MatthiasVermot-Desroches/Projet-ROB3/README.md

# Projet-ROB3: Polydar
robot Cartographe autonome à 6 roues    
  
Six-wheeled autonomous mapping robot
