MatthiasVermot-Desroches/Projet-ROB3/ROS/README.md

Ce dossier contient tous les scripts utilisés pour la partie ROS du projet.
Cela inclut la création d'une carte à partir d'un LiDAR et un début d'autonomisation des déplacements du robot
