MatthiasVermot-Desroches/Projet-ROB3/Code arduino/detection ultrasons/README.md

Ce dossier contient tout le programme axé sur la rotation du robot en cas de détection d'obstacles à l'aide de capteur ultrason.
Le programme servirai dans les cas où le LIDAR tombe en panne ou en cas d'objets non détectés par le LIDAR (notamment les objets en verres comme des fenêtres, vitres etc.)

Le dossier rotation_servomoteurs contient le code devant assurer la rotation du robot à l'aide de servomoteurs. La version actuelle est fonctionnelle mais uniquement avec un seul servomoteur de branché.
Ce fichier est à l'abandon pour l'instant car, suite à un changement de châssis, nous n'utilisons pour l'instant plus de servomoteurs.

Le dossier rotation_moteurs contient le code devant assurer la rotation du robot à l'aide de moteurs, donc de variations den vitesses.
La version actuelle n'a pas été testée en pratique (elle a été testé avec 2 moteurs branchés mais non fixés sur le châssis).
