MatthiasVermot-Desroches/Projet-ROB3/Vermot-Desroches Matthias/Boitier arduino/Readme.md

Réoertoire contenant les fichiers du projet boitier arduino
