MatthiasVermot-Desroches/Projet-ROB3/Rapports seances/rapportsMatthiasVD/rapportseance20.docx

Vermot-Desroches Matthias

Rapport de séance n°20

During this session, I finally managed to install ROS on the NVIDIA card and started learning how to use it. I also re made the Arduino card’s box.

First, with Nino, we changed the place of the home directory in the NVIDIA card. This was done to have enough space for the ROS installation on the card instead of the hard disk’s card since we feared a lack of space. Then, we started the ROS installation using the snap command. However, the installation tutorial with this command was not full and even after following it, we still did not have ROS installed. So, we used the apt command in order to install ROS even though we could lack some space. In the end, we had enough space inside the hard disk. And, we now have a lot of space (50 Giga) thanks to the moving of the home directory inside the card.

After that, we spent the remaining time doing ROS tutorials on the official site. For some of them, we needed another screen as they required a graphic interface, and a terminal was not one. So, we took a screen in the Fablab, but for some reason, it did not show anything when plugged to the card. After speaking with Mr. Masson, we could use the rooms projector, and everything went nicely.

Then, I printed the first version of the Arduino’s box. The printing had some issues, so the box was definitely going to be remade, but I used it to check if any changes needed to be done. It turned out that I needed to adjust the fixation point of the card (the extruded cylinder) and the fixation points of the box. Here are some pictures of the first model :

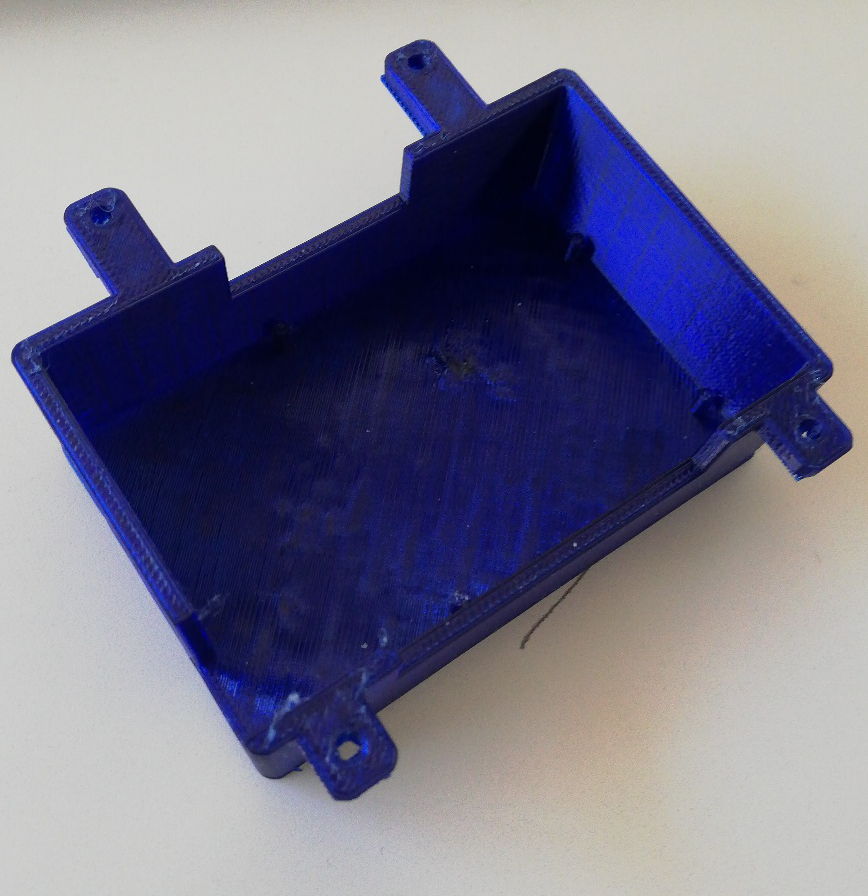
[picture p11: figure]
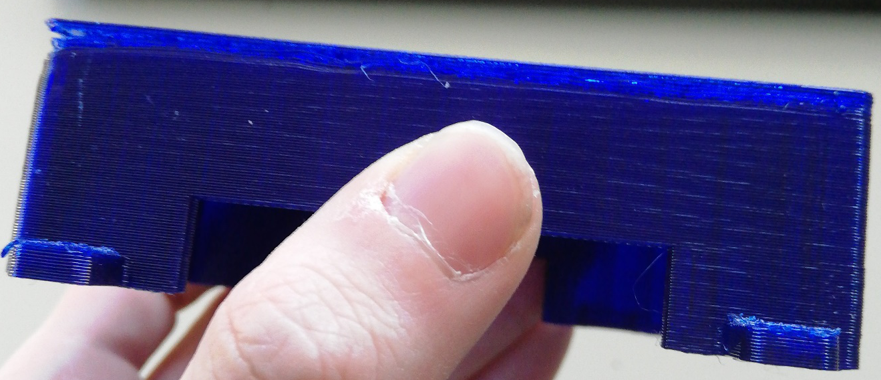
[picture p12: figure]

You can see the printing error that occurred on the picture above.

After that, I modified the CAD model, printed it and checked it. The box is usable, the Arduino card fitted inside, and it can be easily fixated on the frame. Here is a picture of it:

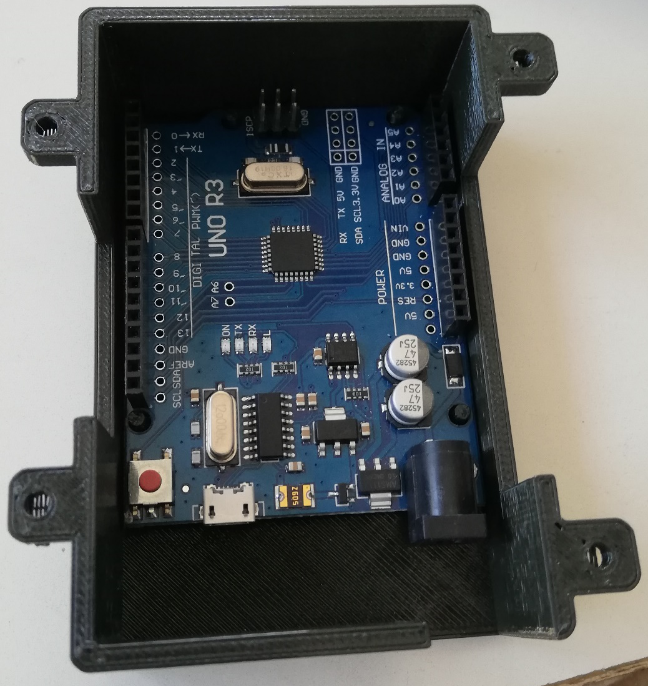
[picture p13: figure]
