MatthiasVermot-Desroches/Projet-ROB3/Rapports seances/rapportsMatthiasVD/rapportseance19.docx

Vermot-Desroches Matthias

Rapport de séance n°19

During this session, I tried again to flash the Nvidia card and started working on an Arduino box that would be fixed on the frame.

I could not finish the download at home during the last session thanks to connections issues. So I tried again with the university network. The download speed was better than my home’s, but some module contained in the download caused some issues. The module was the CUDA one, as for some reasons, the download percentage would randomly decrease instead of increase (going from 30% to 10% for example). This lead to the download being launched at 8 a.m. and not being over at 12 a.m.

At first, I tried to fix the CUDA problem by skipping some steps in the download or just changing the Wi-Fi to my phone’s. But it did nothing.

While waiting for the download to be done, I spoke with Xavier on what I could do in the meantime.

Xavier told me that I could make a better fixation for the Arduino card and maybe improve the motors driver’s one. So, I designed a new box that would be fixed on the same floor as the driver’s one. Here is a picture of the CAD model:

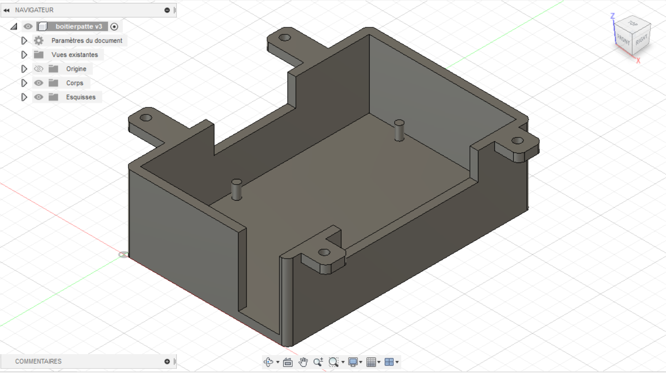
[picture p14: figure]

You can see that there are little parts on the high corners of the CAD. They are here in order to fix the box onto the frame from below, as it would be easier to plug the cables on the Arduino card. The hole in the front is meant to let enough space for the supply plug to fit inside it. The cylinder inside the box are made to maintain the Arduino card in position.

I will try to print the box using a 3D printer during the week.

Next session, I will try another way of downloading ROS on the Nvidia card, verify if the Arduino box is correct and if it is start working on improving the driver’s fixation.
