MatthiasVermot-Desroches/Projet-ROB3/Rapports seances/rapportsMatthiasVD/rapportseance15.docx

Vermot-Desroches Matthias

Rapport de séance n°15

During this session, I finalized placing the motors’ driver and the cable on the frame and started placing the ultrasound sensors.

First, with a huge help from Mr. Masson, we welded the cables in order for them to have a better fixation. Then, I pierced new holes on the frame and screw the lustre terminal on the frame. This made sure that the cables would not be everywhere on the frame. Here is a picture of its position on the frame :

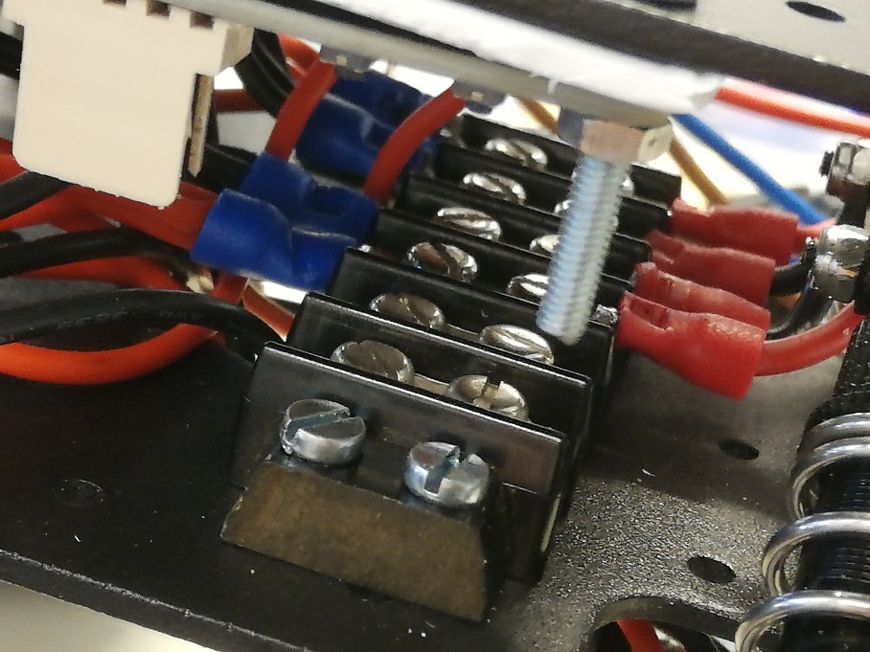
[picture p16: figure]

You can see that I placed the lustre terminal on the bottom floor of the frame and right under the driver’s position, as it will make the cables even less twisted in the frame.

As you saw on the last picture, I also worked on the driver’s fixation. I followed the sketch I did during the last session and remade a plastic support piece. After finding the right screws and nuts, I finally fixated the driver. Here is a picture of it:

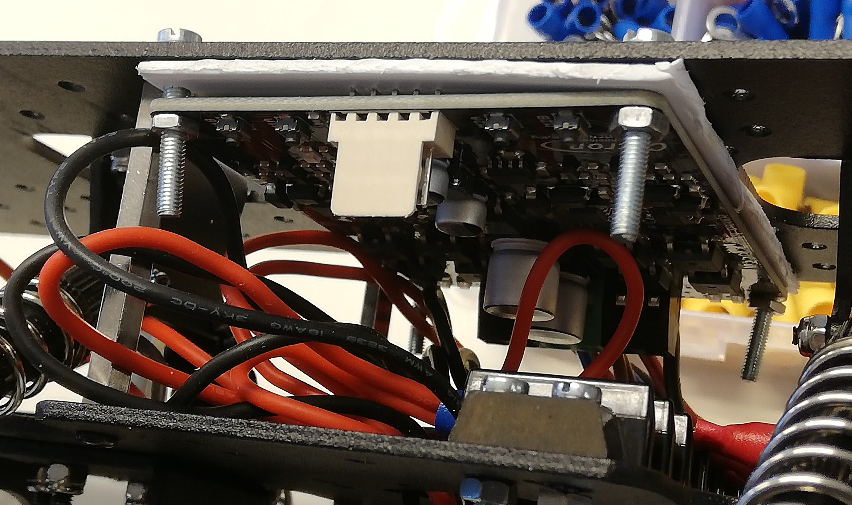
[picture p17: figure]

You can see that not all the bolts are standing straight, it is again due to the plastic being dilated when I pierced it, but this time it should not create any problems. Also, in the end, according to Mr. Masson, the struts were not needed, this is why there are none on the picture.

During the remaining time of this session, I tried to fix the ultrasound sensors on the frame using the adequate support pieces. I decided to place them in a way that make them in the middle of the 2 floors of the frame. So, I pierced new holes on the frame again and placed the support pieces.

Here are pictures of the sensors placed on the frame:

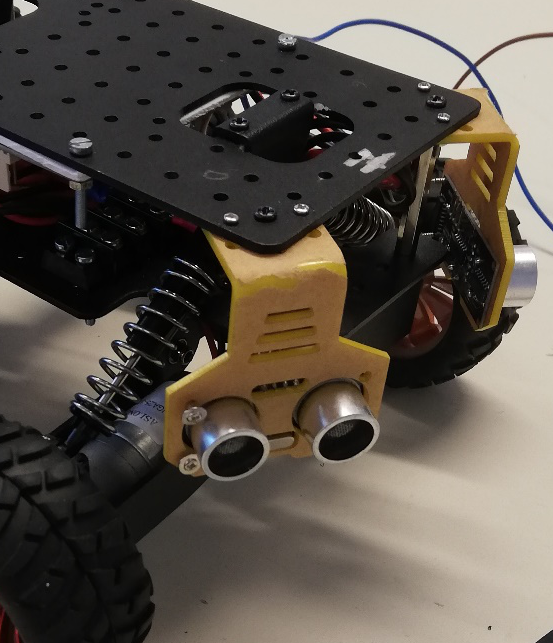
[picture p18: figure]
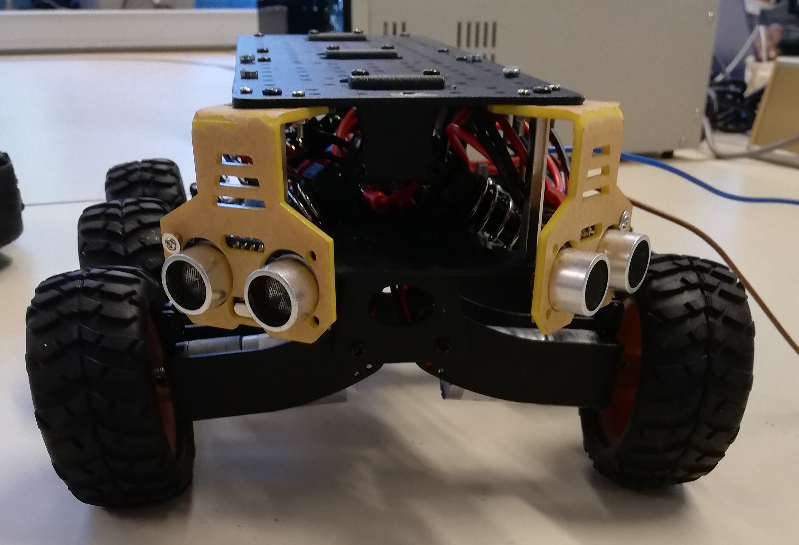
[picture p19: figure]

You can see that, at least for now, the sensors are not on the middle of the frame. But I decided that this position will be what we need.

A problem rose after this, I placed everything on the same side, so I can’t pierce new holes as it could damage the driver. During the next session, I will move the sensors to the other side of the frame and fix a little laser sensor to start making measurements and using the Nvidia card.
