MatthiasVermot-Desroches/Projet-ROB3/Rapports seances/rapportsMatthiasVD/rapportseance4.docx

Vermot-Desroches Matthias

Rapport de séance n°4

During this session, I realized the first wood plate for the wooden model. I tried to make a second one with the same parameter on the cutting machine, but for some reason, the extremities turned into charcoal.

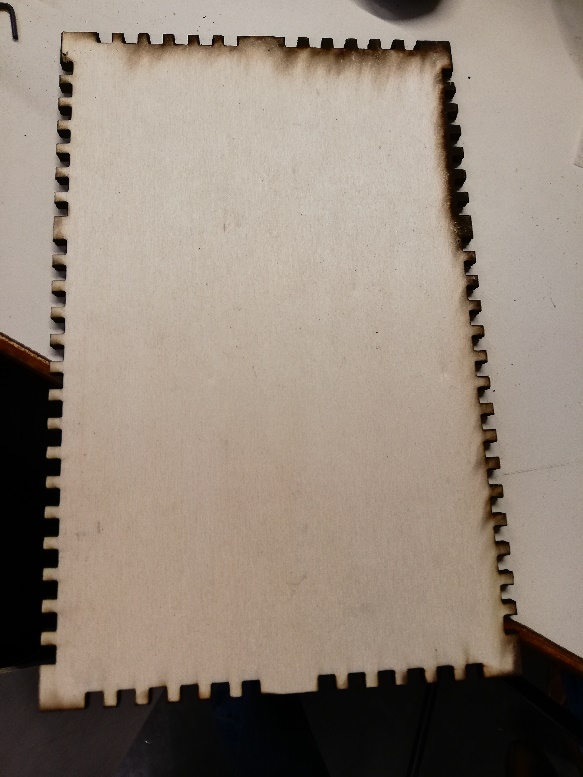
[picture p57: figure]

Here is a picture of the plate I managed to cut.

We also received our motors and wheels, but the diameter of the wheels was smaller than expected and some pieces were different. Mister Masson provided some spare pieces and we chose to use the wheels for now, or at least for the wooden model. Following this decision, I assembled the motors, wheels and other pieces to make the wheel+motor ensemble that we will fix on the servomotor later.
