MatthiasVermot-Desroches/Projet-ROB3/Rapports seances/seance21.pdf

25/04

Le système de fonctionnement du LIDAR a été revue. Les servo-moteurs utilisés pour changer l’inclinaison du miroir ont été remplacés par un moteur pas à pas. Ainsi, le problème de transmission du mouvement des servos moteurs vers le miroir est réglé et la précision est accrue. Le nouveau système fonctionne grace à un plateau positionné sur une vise sans fin qui est fixé au moteur pas à pas via un coupleur. Le plateau consiste de deux plaques qui prennent en étaux la bague qui sert a faire varier la rotation du miroir. Voici la pièce modélisée sur FreeCAD :

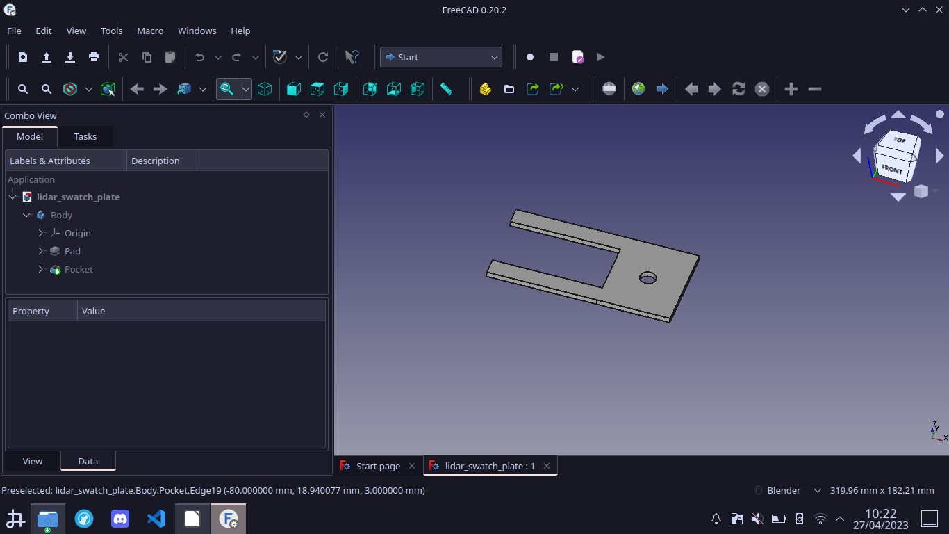
[picture p83: figure]

Le rotor à également été remodélisé pour y ajouter des crans pour que la couroie adhère mieux :

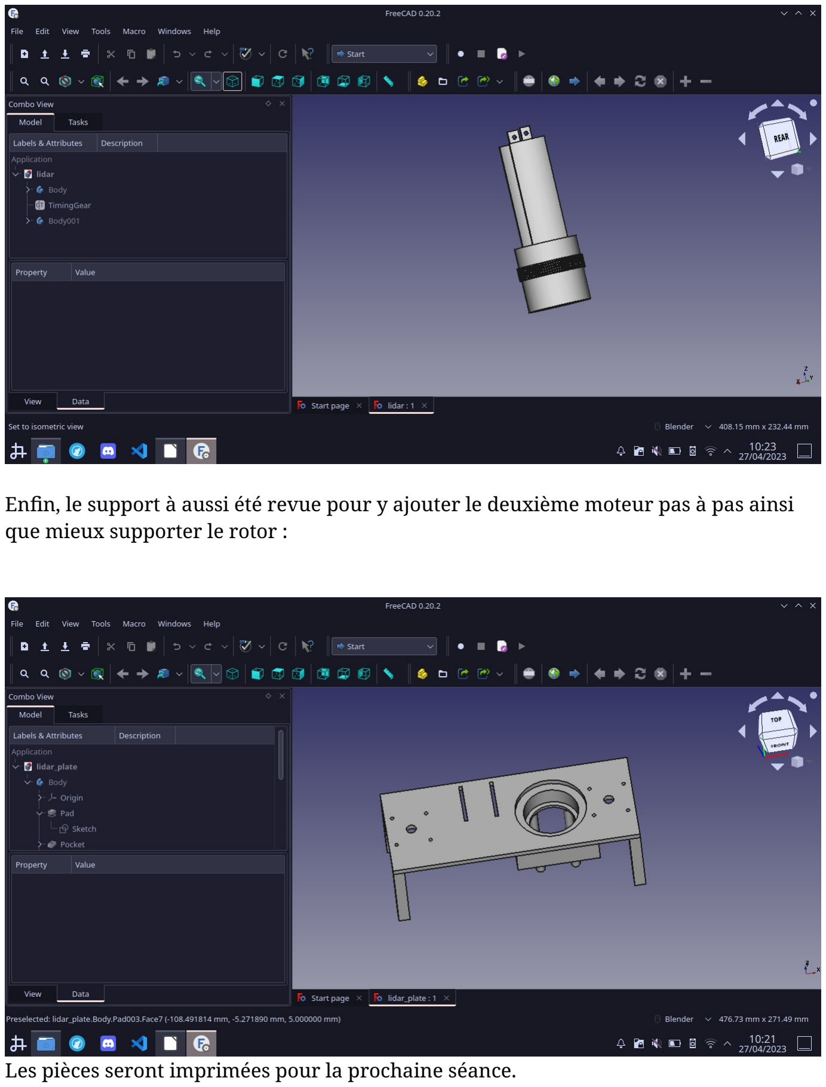
[picture p84: page 2]

Enfin, le support à aussi été revue pour y ajouter le deuxième moteur pas à pas ainsi que mieux supporter le rotor :

Les pièces seront imprimées pour la prochaine séance.
