MatthiasVermot-Desroches/Projet-ROB3/Rapports seances/seance20.pdf

11/04

Installation de ROS avec Mathias et Nino sans oublier de formatter la carte SD et de déplacer le répertoire /home vers la carte SD. On ne peut pas avancer sur la programmation du robot avant d’avoir réussi a faire fonctionner ROS ce qui bloque notre progression. En attendent, j’ai travailler sur l’amélioration du lidar pour le faire fonctionner en 3D. La solution la plus rapide est de refaire les pièces avec la bonne précision et en rallonger les supports car actuellement, il y a trop de frictions ce qui complique la ratation du rotor et bloque le fonctionnement des servos-moteurs (et donc pas de 3D) .
