MatthiasVermot-Desroches/Projet-ROB3/Rapports seances/seance16.pdf

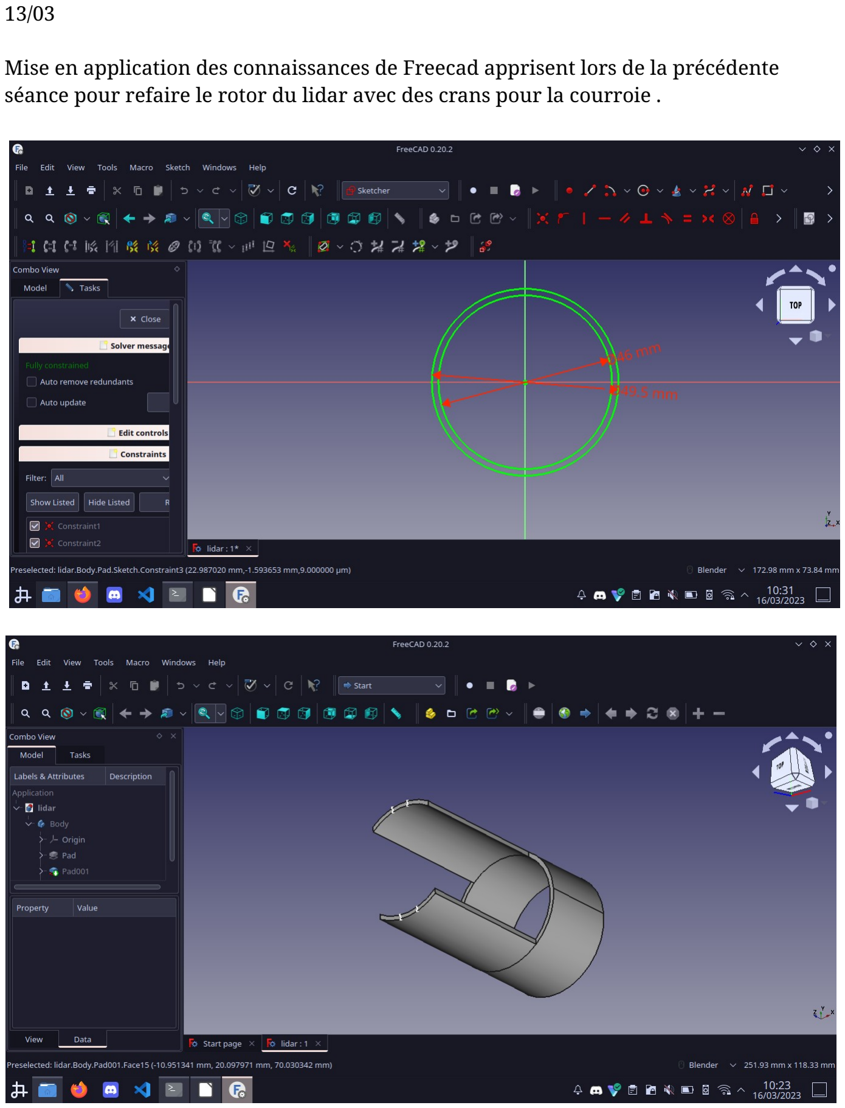
[picture p87: page 1]

13/03

Mise en application des connaissances de Freecad apprisent lors de la précédente séance pour refaire le rotor du lidar avec des crans pour la courroie .

Mise en pause de la fabrication du Lidar pour l’utilisation d’un Lidar industriel RPLIDAR et tentative de le faire fonctionner avec le logiciel fournit “Robostudio”, sans succès.
