MatthiasVermot-Desroches/Projet-ROB3/Rapports seances/seance14.pdf

Séance 14 28/2

Nettoyage des dernières pièces puis assemblages

Le reste de la séance a été passé à essayer de mettre en place les liens entre les servomoteurs et la bague, sans succès… (compliqué à tordre correctement)

IL faut aussi refaire le rotor et ajouter des crans dessus pour que la courroie adhere correctement.

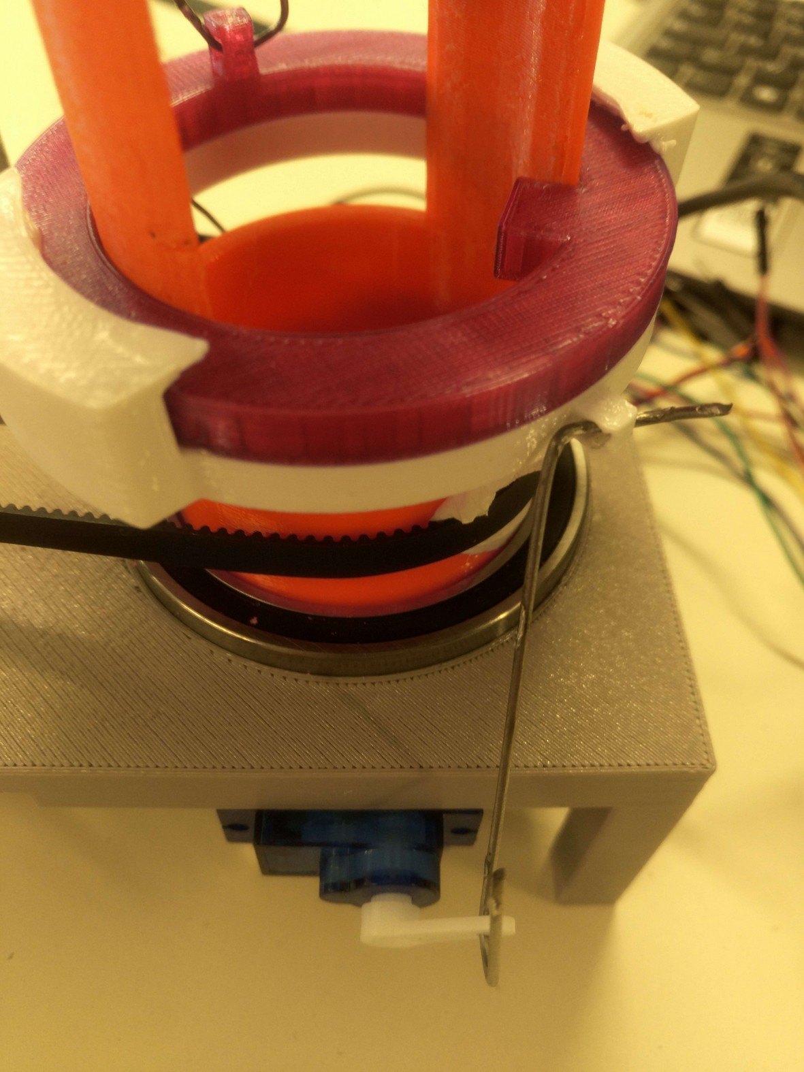
[picture p88: figure]
