MatthiasVermot-Desroches/Projet-ROB3/Rapports seances/seance13.pdf

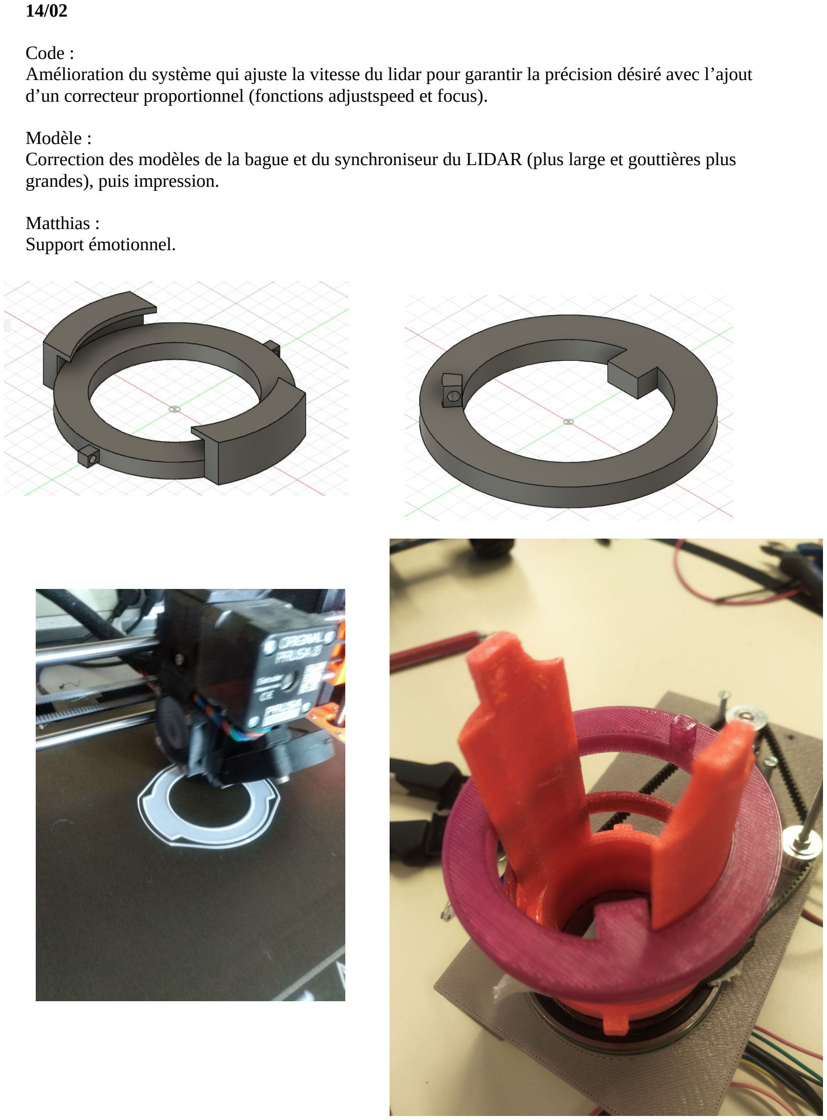
[picture p89: page 1]

14/02

Code :
Amélioration du système qui ajuste la vitesse du lidar pour garantir la précision désiré avec l’ajout d’un correcteur proportionnel (fonctions adjustspeed et focus).

Modèle :
Correction des modèles de la bague et du synchroniseur du LIDAR (plus large et gouttières plus grandes), puis impression.

Matthias :
Support émotionnel.
