MatthiasVermot-Desroches/Projet-ROB3/Rapports seances/seance9.pdf

16/12

Après avoir révisé les pièces, voici le résultat de la nouvelle impression :

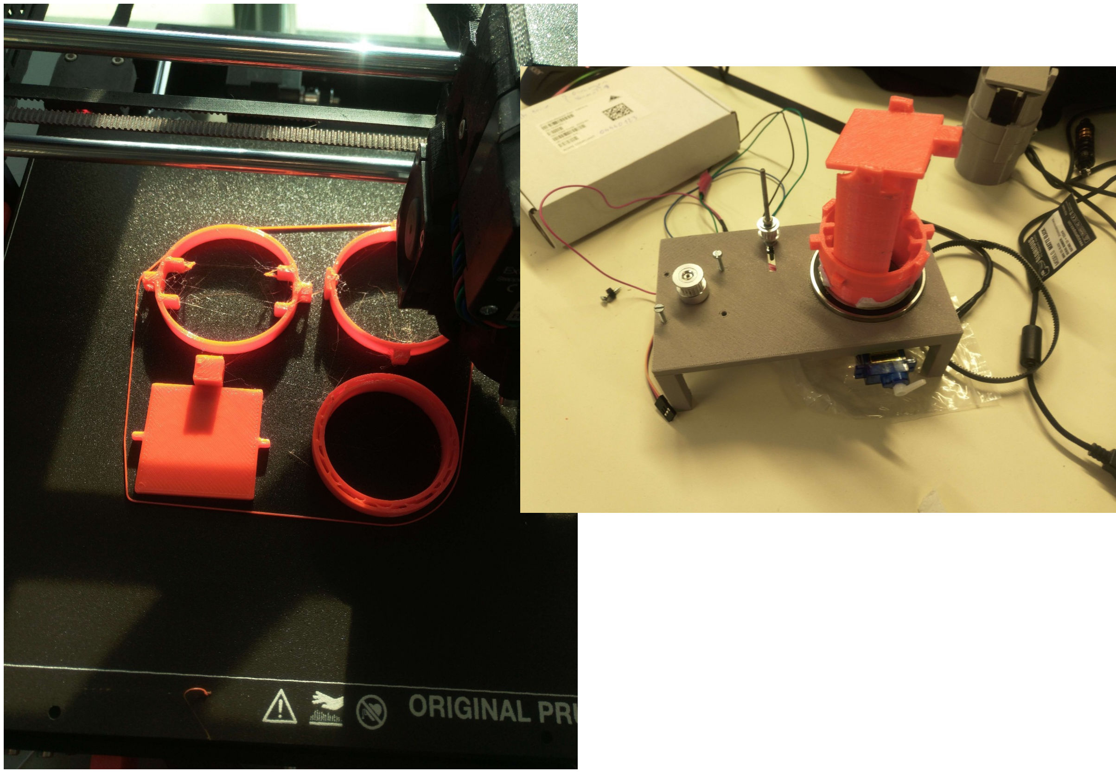
[picture p90: figure]

Il reste encore une erreur sur le synchroniseur mais cette pièce peut être ré-imprimé en quelques minutes.
Il faut cependant trouver une tige assez fine et résistante pour relier le servomoteur à la bague.
