MatthiasVermot-Desroches/Projet-ROB3/Rapports seances/seance7.pdf

09/12

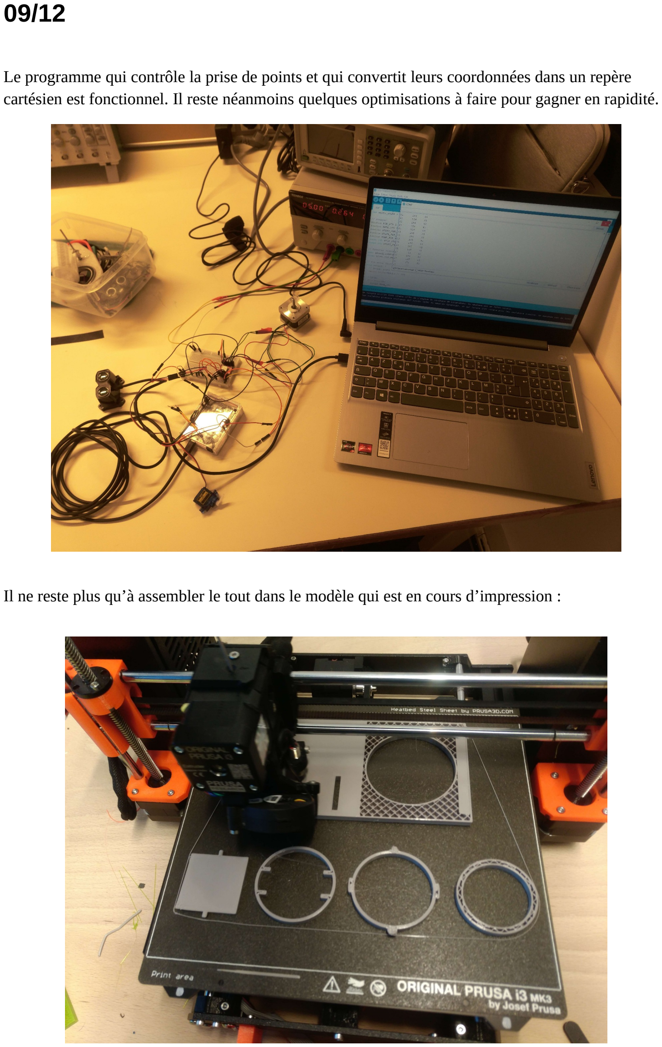
[picture p91: page 1]

Le programme qui contrôle la prise de points et qui convertit leurs coordonnées dans un repère cartésien est fonctionnel. Il reste néanmoins quelques optimisations à faire pour gagner en rapidité.

Il ne reste plus qu’à assembler le tout dans le modèle qui est en cours d’impression :
