MatthiasVermot-Desroches/Projet-ROB3/Rapports seances/seance6.pdf

06/12

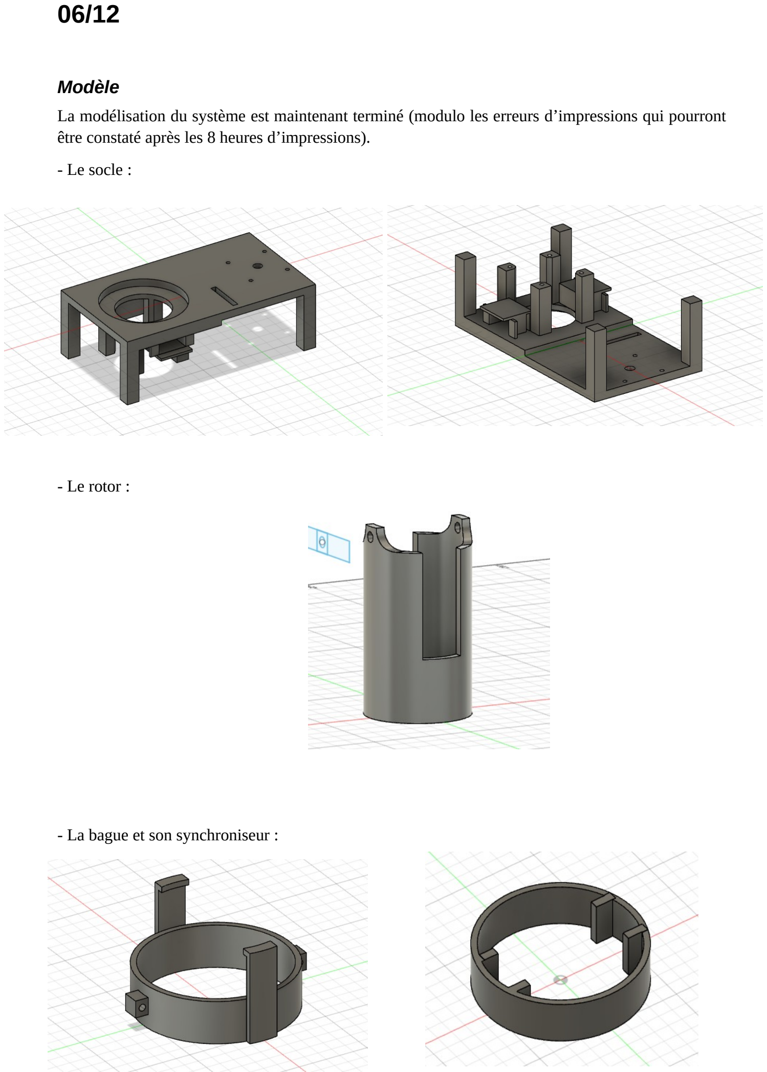
[picture p92: page 1]

Modèle
La modélisation du système est maintenant terminé (modulo les erreurs d’impressions qui pourront être constaté après les 8 heures d’impressions).
- Le socle :
- Le rotor :
- La bague et son synchroniseur :

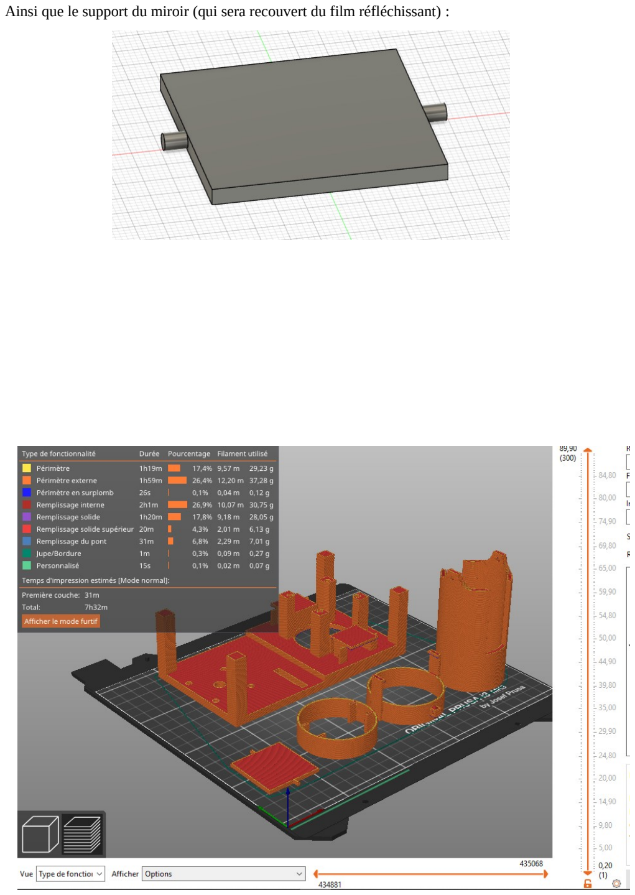
[picture p93: page 2]

Ainsi que le support du miroir (qui sera recouvert du film réfléchissant) :
