MatthiasVermot-Desroches/Projet-ROB3/Rapports seances/seance4.pdf

15/11

Impression
Après nettoyage et un simple ponçage des pièces imprimées à la dernière séance ainsi que l’impression d’une courroie en filament flexible, voici le résultat :

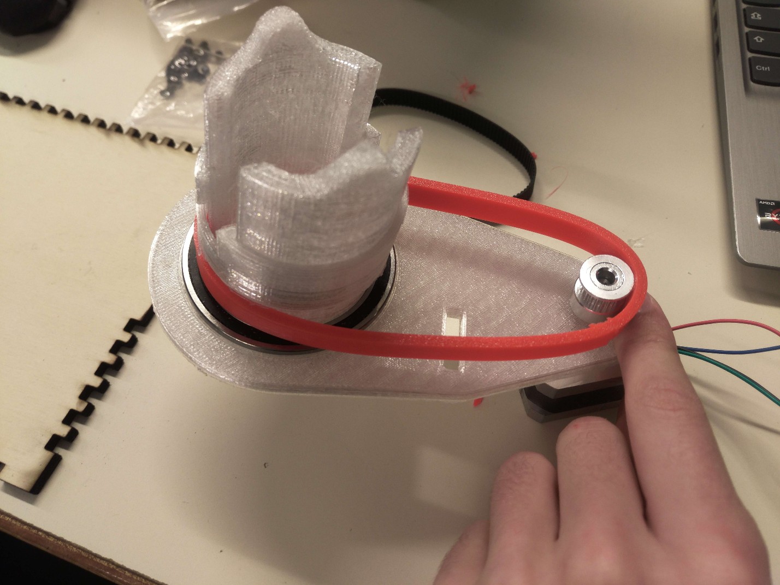
[picture p94: figure]

Plusieurs problème émerge alors :
- Courroie trop large, trop épaisse et trop longue
- Jeu entre le roulement à bille et le rotor
- Syncroniseurs qui translate difficilement
- Plusieurs autres défauts mineurs
Les modèles ont été revu et sont en attente d’impression

LIDAR
Lecture de la datasheet du capteur pour une utilisation rapide (>1000hz).
Début du programme permettant de prendre un nombre de point et de les localiser dans l’espace pour réaliser la cartographie.
