MatthiasVermot-Desroches/Projet-ROB3/Rapports seances/seance3.pdf

28/10

## Modélisation

Finalisation de la modélisation des pièces du LIDAR

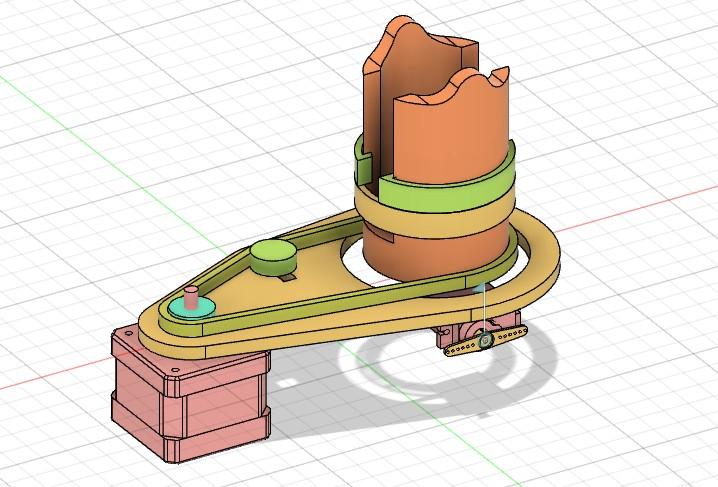
[picture p95: figure]

En orange : la bague
En vert : le synchroniseur En rouge: l’arbre principale En jaune : la courroie
En orange : le socle

## Impression

Début de l’impression 3d des pièces du LIDAR

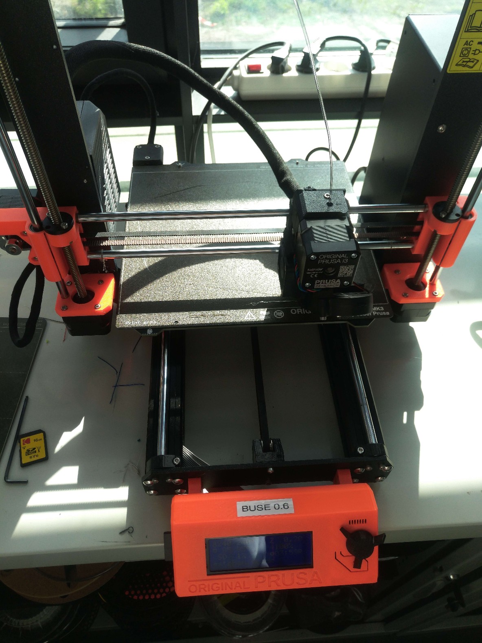
[picture p96: figure]
