MatthiasVermot-Desroches/Projet-ROB3/slide soutenance/soutenance Polydar.pdf

## Le Polydar

Gissinger Esteban et Vermot-Desroches Matthias ROB 3

année 2022-2023

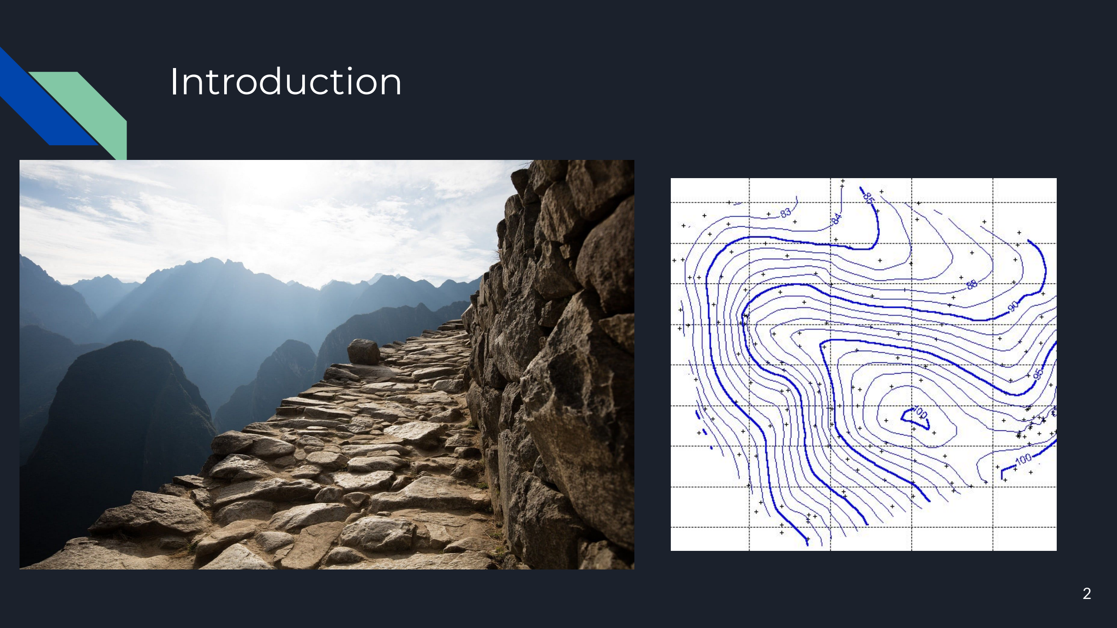
[picture p98: page 2]

Introduction

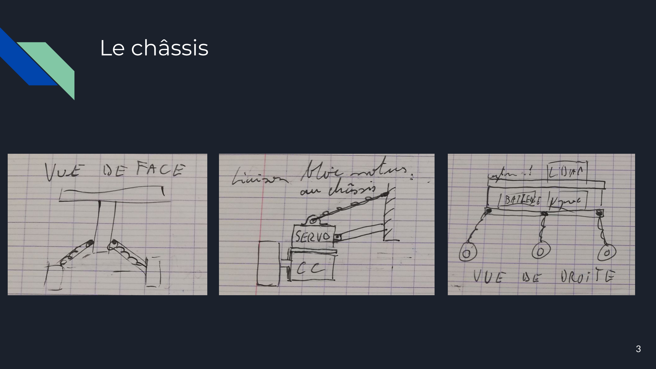
[picture p99: page 3]

Le châssis

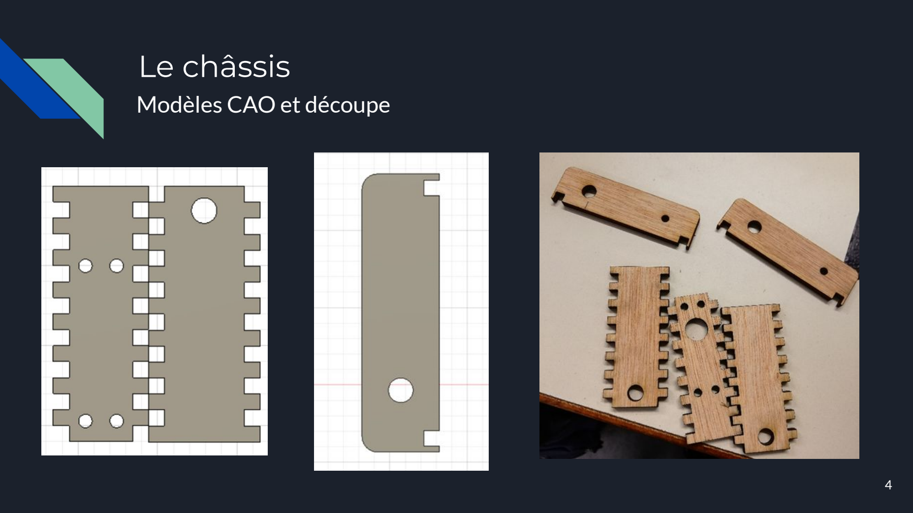
[picture p100: page 4]

Le châssis

Modèles CAO et découpe

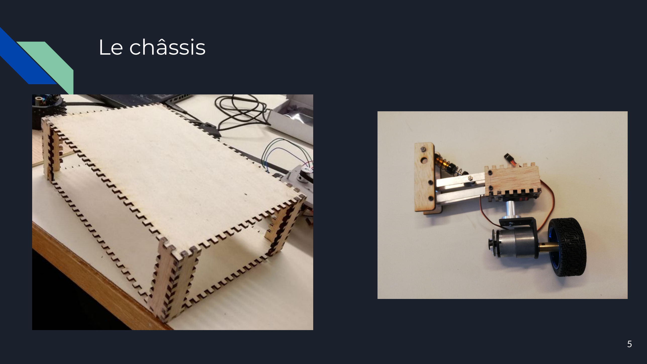
[picture p101: page 5]

Le châssis

Le chassis

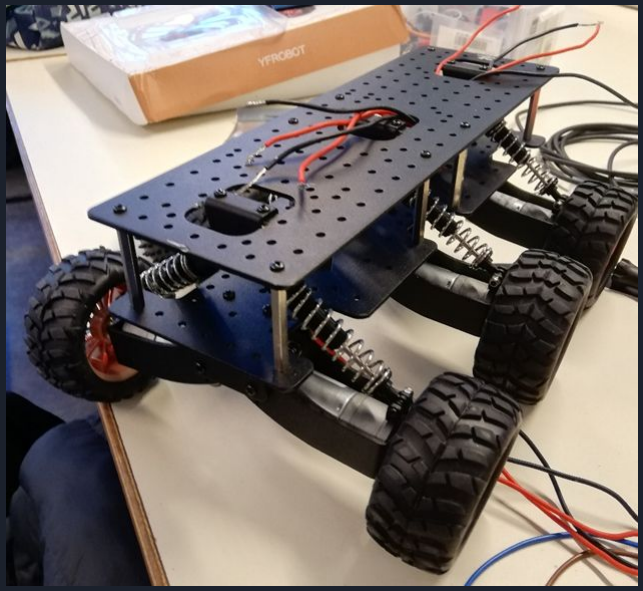
[picture p102: figure]
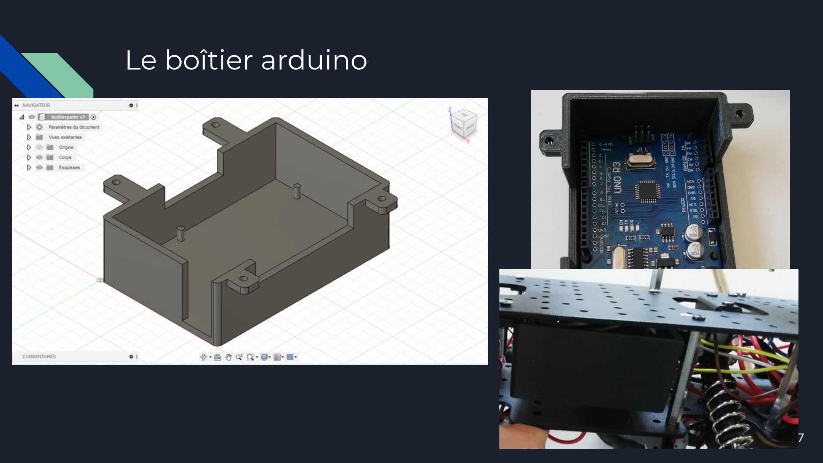
[picture p103: page 7]

Le boîtier arduino

le boîtier arduino

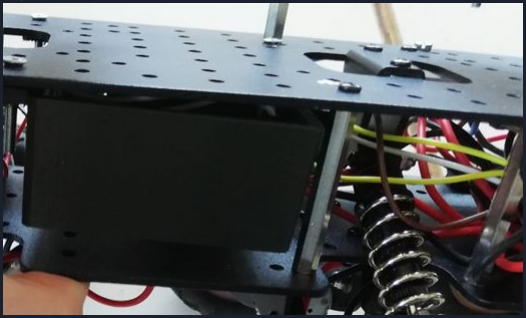
[picture p104: figure]

driver moteur ? capteurs ultrasons? étage pmma ?

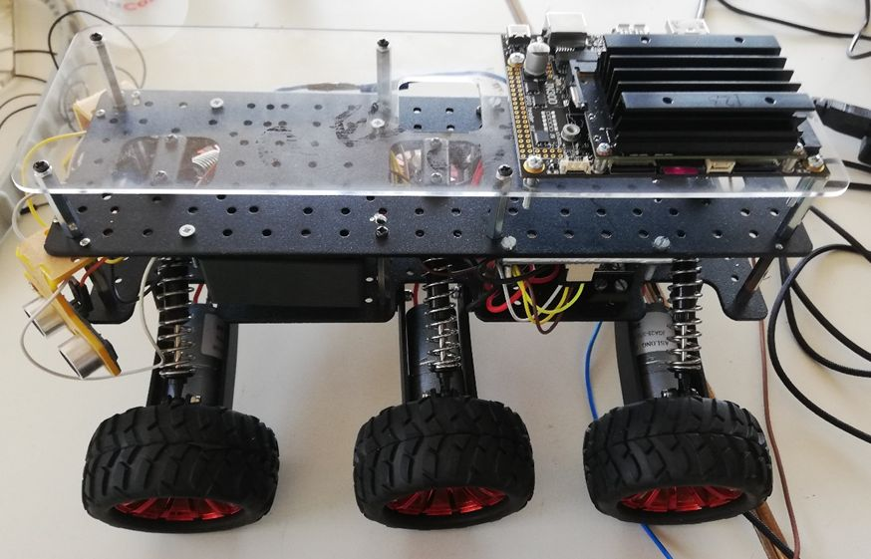
[picture p105: figure]

Le programme Arduino de la commande des moteurs

But : détecter des objets que le Lidar ne peut pas voir. exemple : une vitre, fenêtre

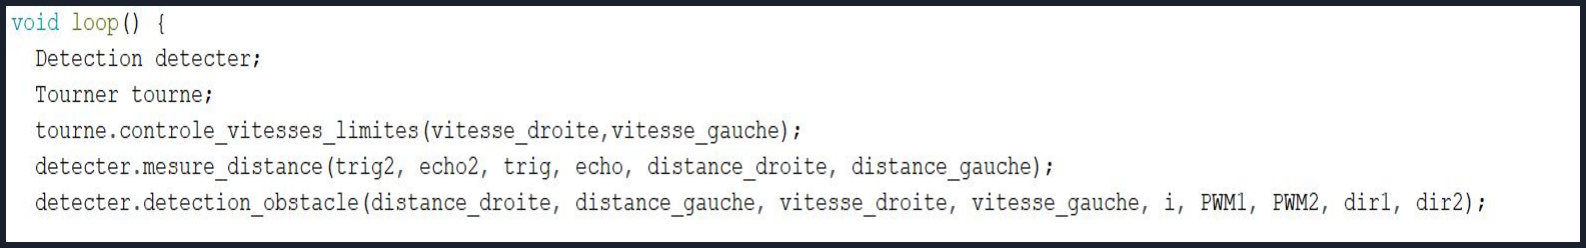
[picture p106: figure]
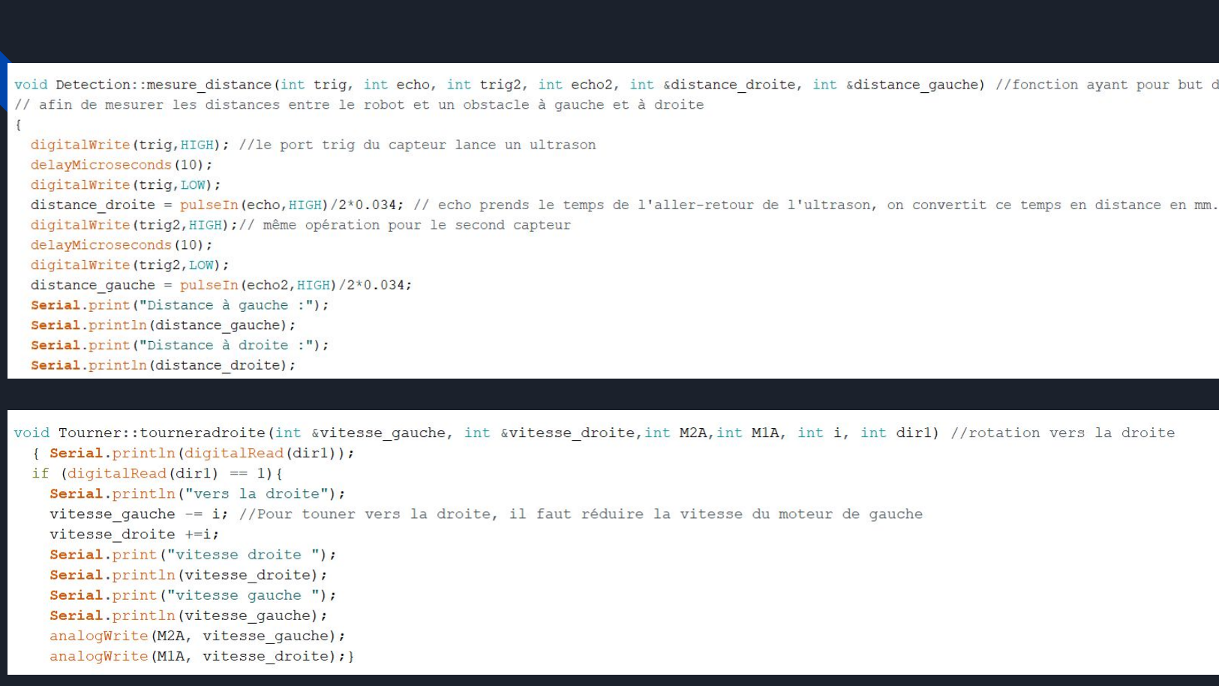
[picture p107: page 11]

Le programme Arduino de la commande des moteurs

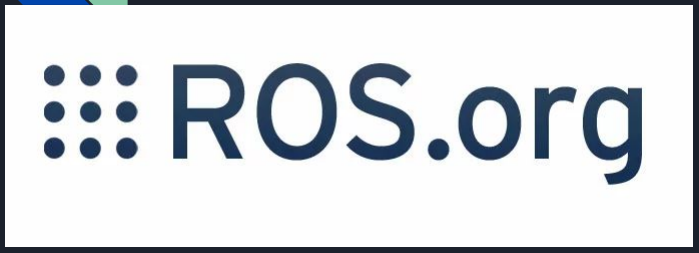
[picture p108: figure]
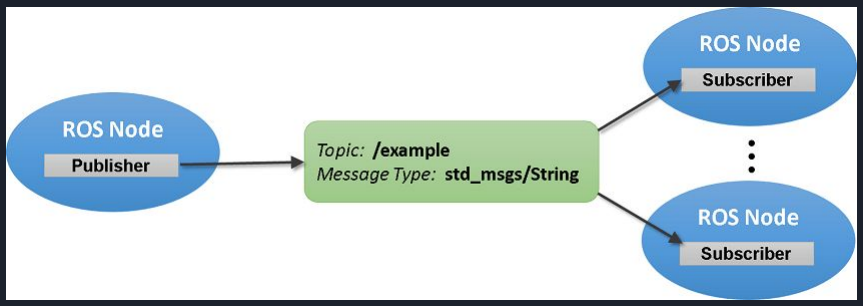
[picture p109: figure]

Permet de diviser les tâches entre Nodes contrôlées par un maître.

-meilleure gestion mémoire et du matériel

Cartographie avec ROS

Robot Operating System

Ensemble de logiciels open source

Cartographie avec ROS

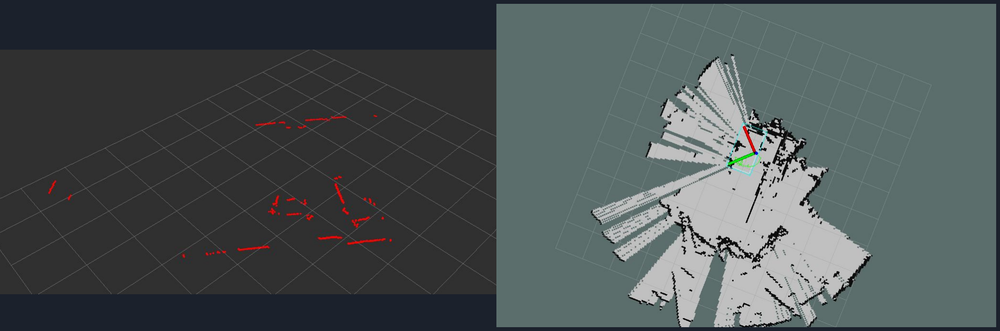
[picture p110: figure]

Sans SLAM | Avec SLAM

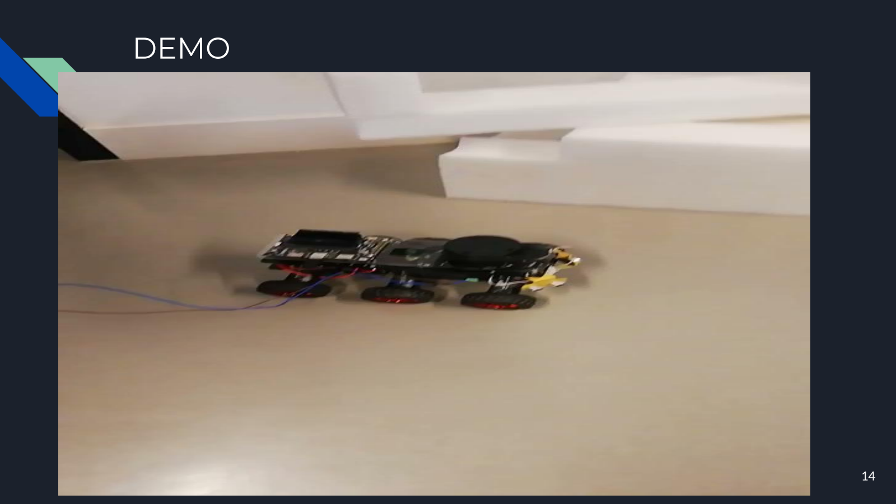
[picture p111: page 14]

DEMO

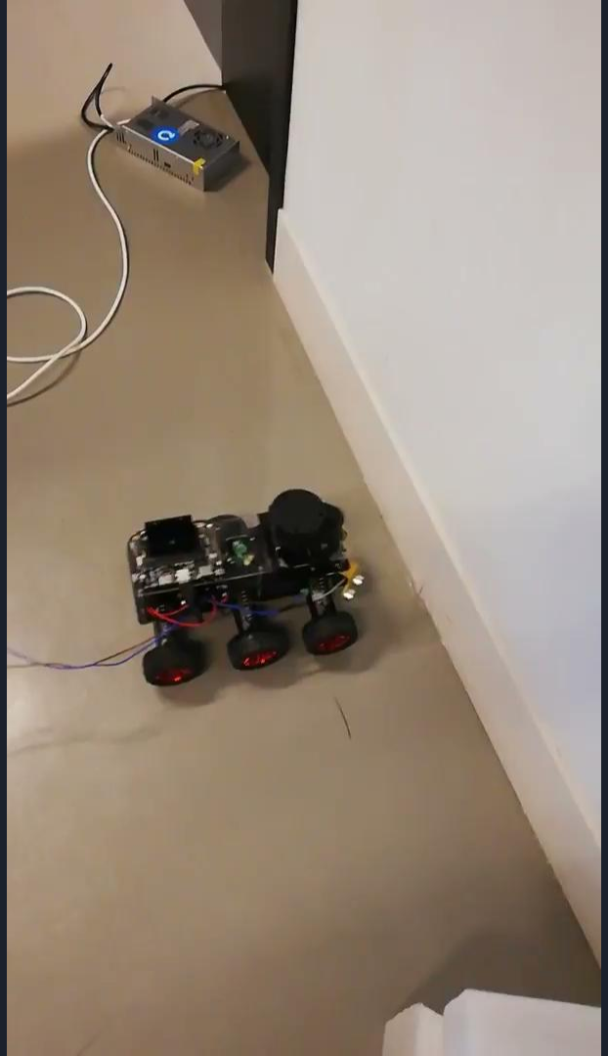
[picture p112: figure]
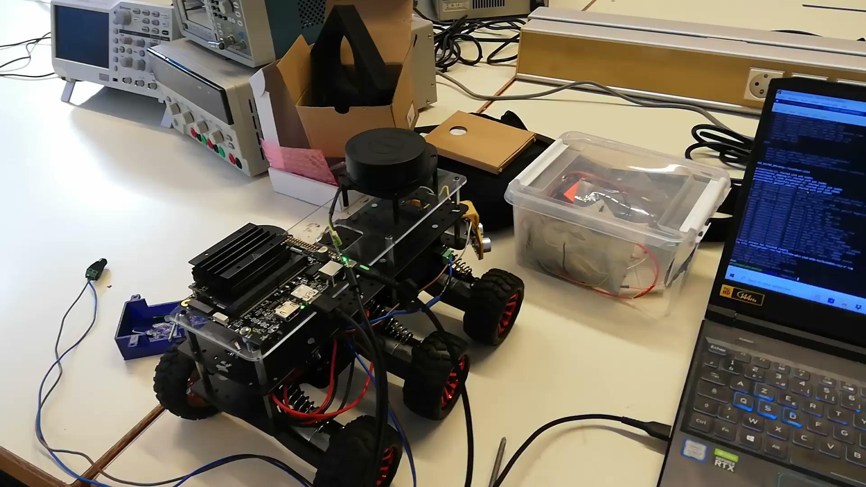
[picture p113: page 16]

PB1 :
lidar 2d

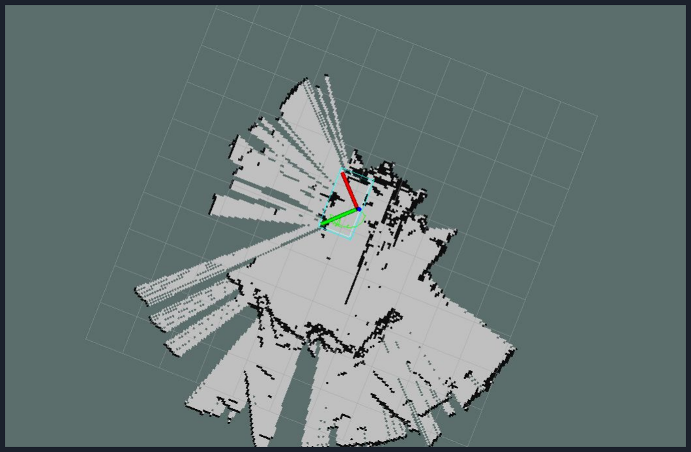
[picture p114: figure]

PB 2 : ROS

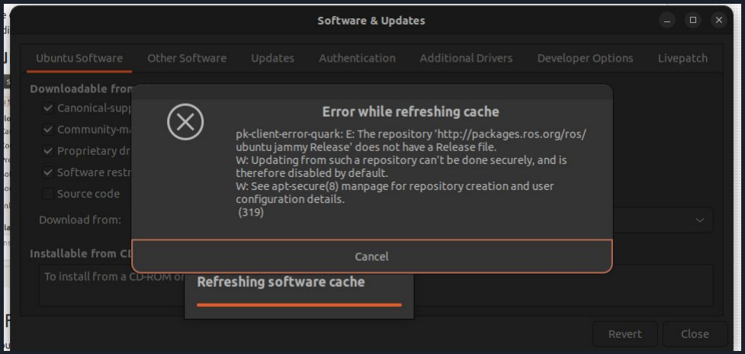
[picture p115: figure]
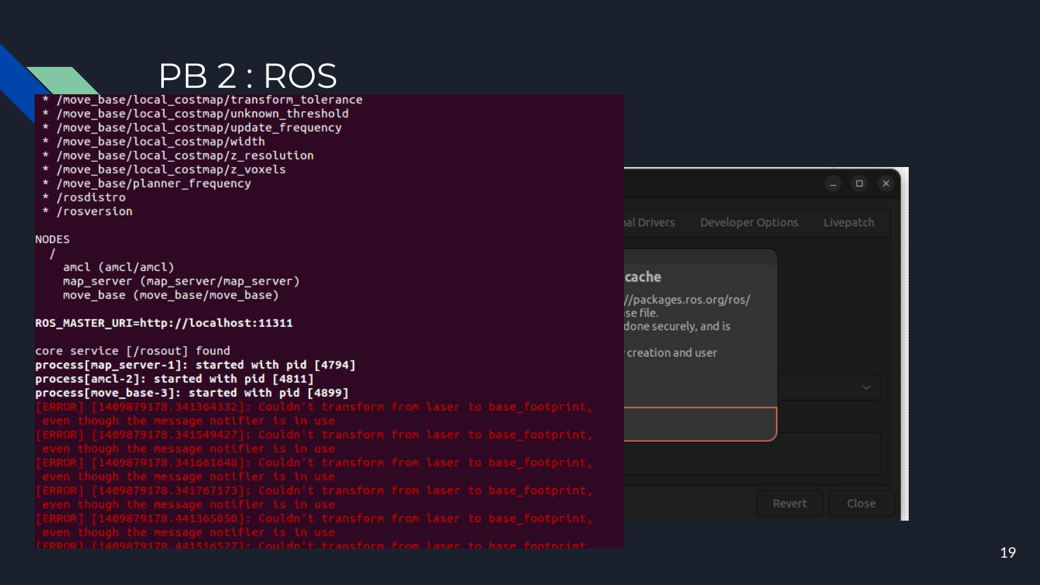
[picture p116: page 19]

PB 2 : ROS

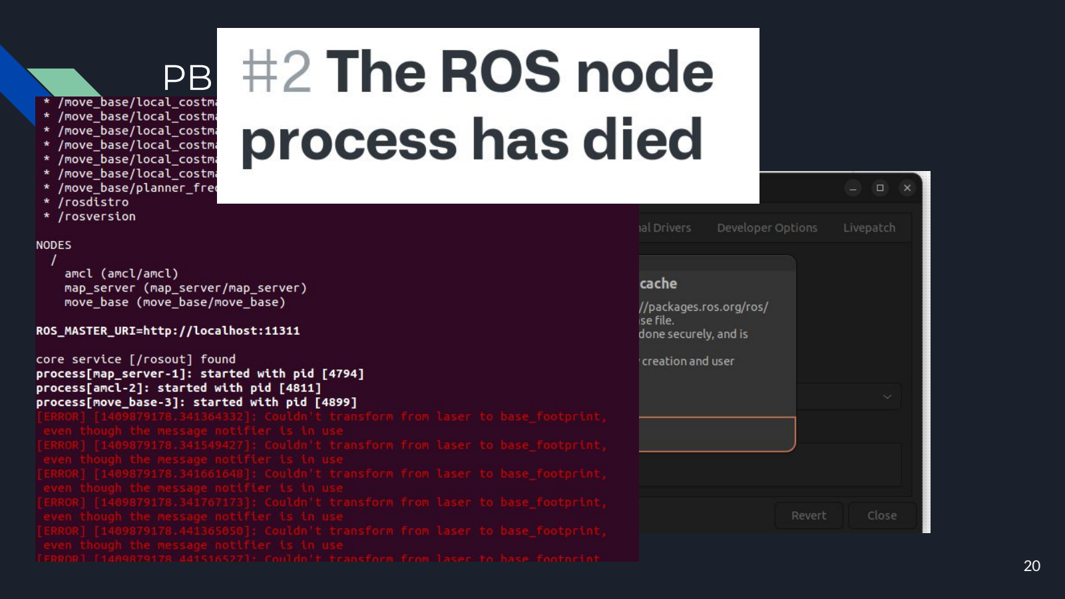
[picture p117: page 20]

PB 2 : ROS

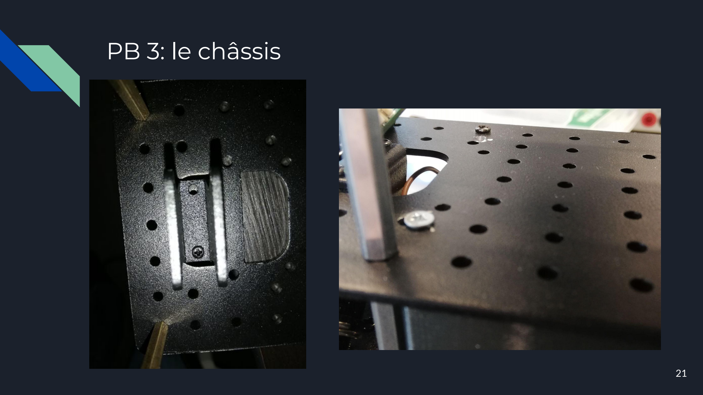
[picture p118: page 21]

PB 3: le châssis

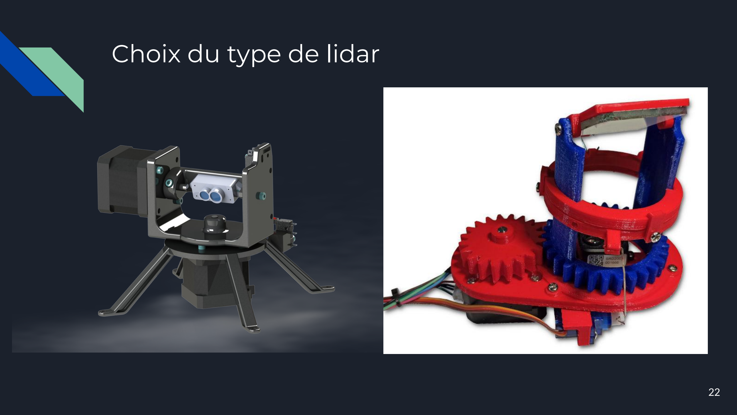
[picture p119: page 22]

Choix du type de lidar

Prototype initial

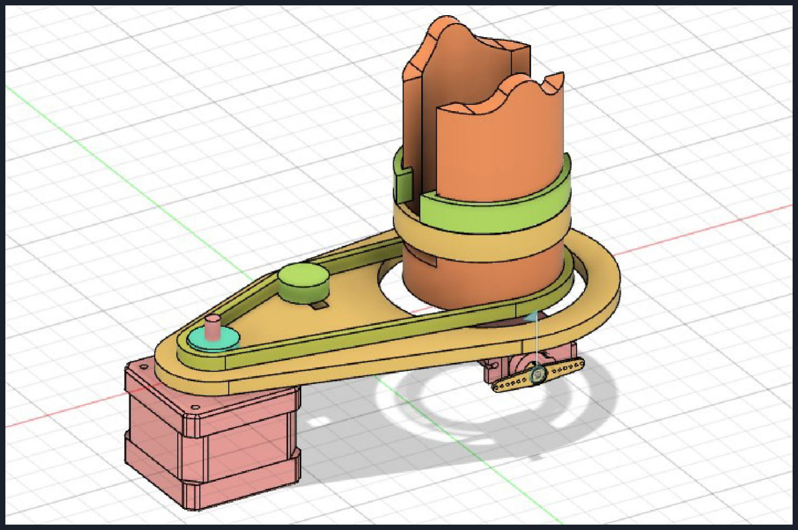
[picture p120: figure]

Mis à jour du design

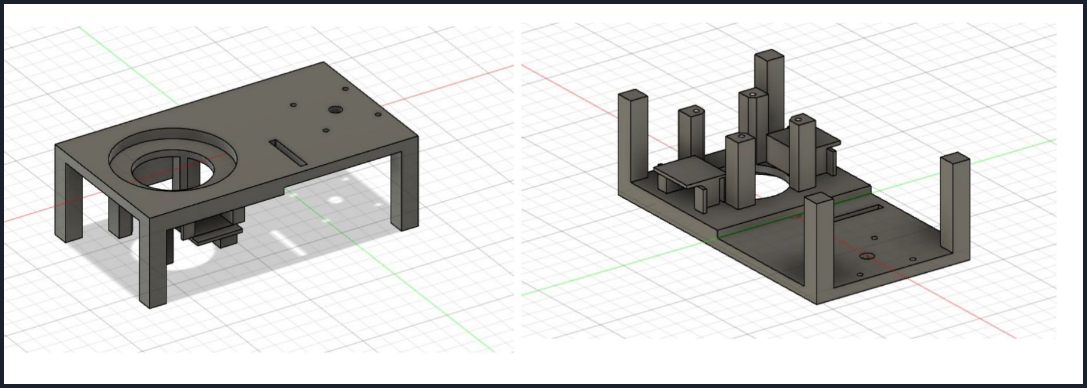
[picture p121: figure]

Mis à jour du design

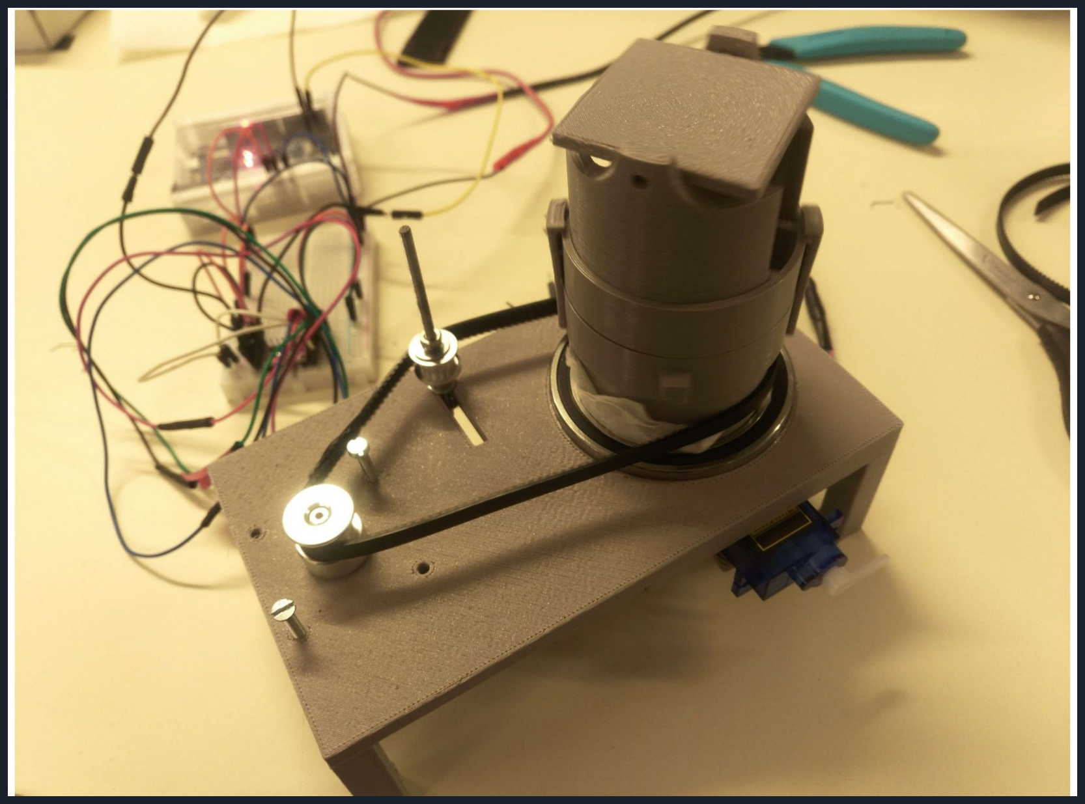
[picture p122: figure]

Correction des erreurs

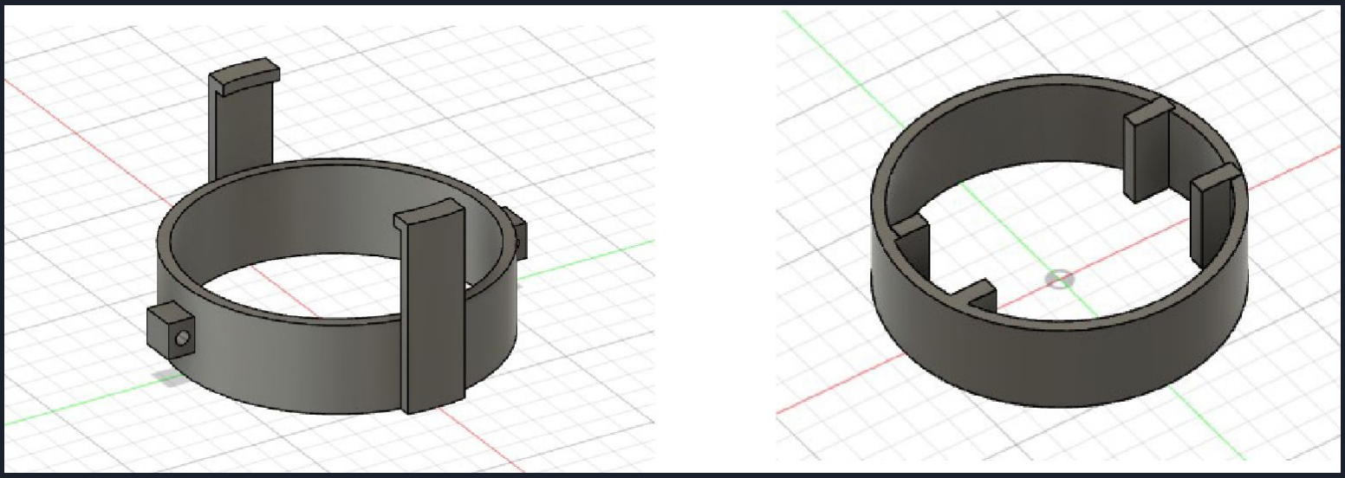
[picture p123: figure]

Nouveaux problèmes

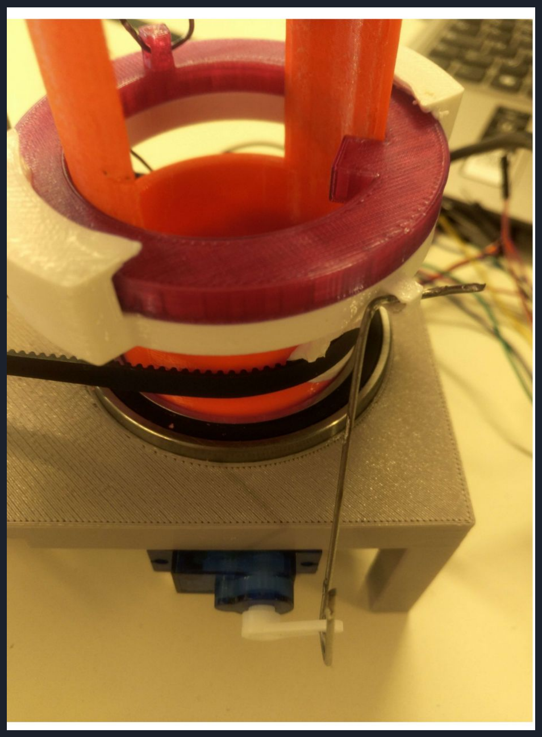
[picture p124: figure]

Visualisation des données

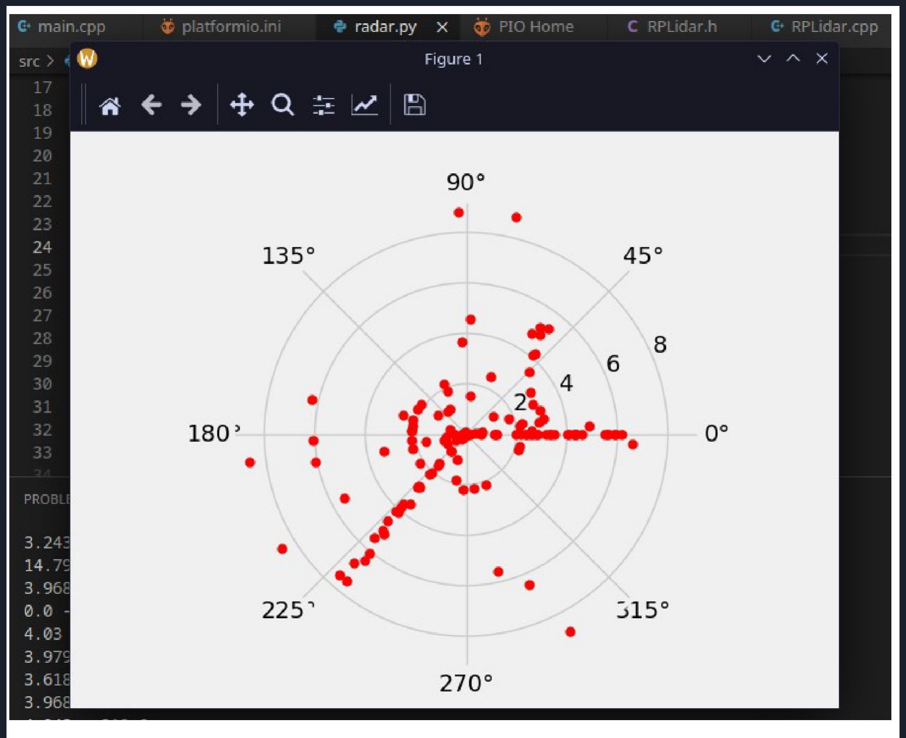
[picture p125: figure]

Cablage LIDAR

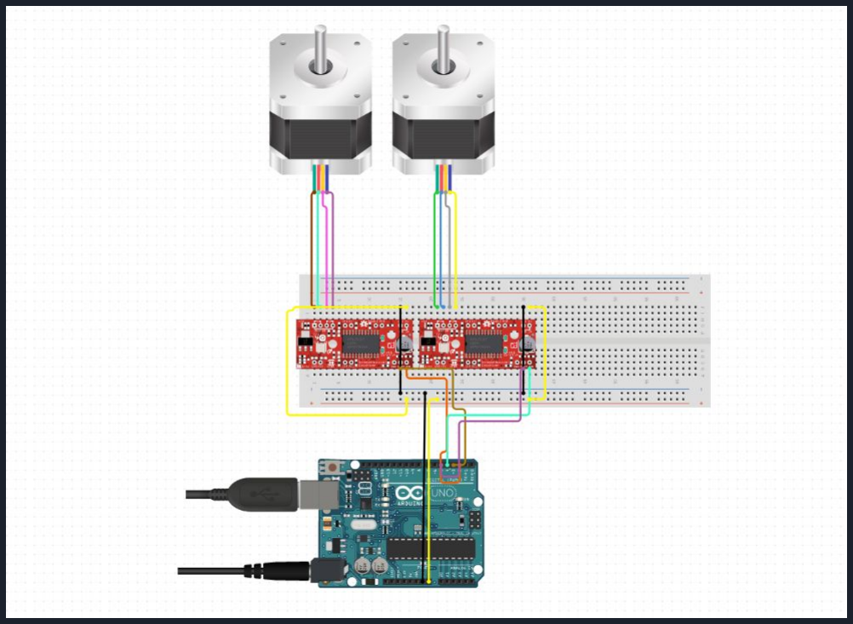
[picture p126: figure]

Programmation LIDAR

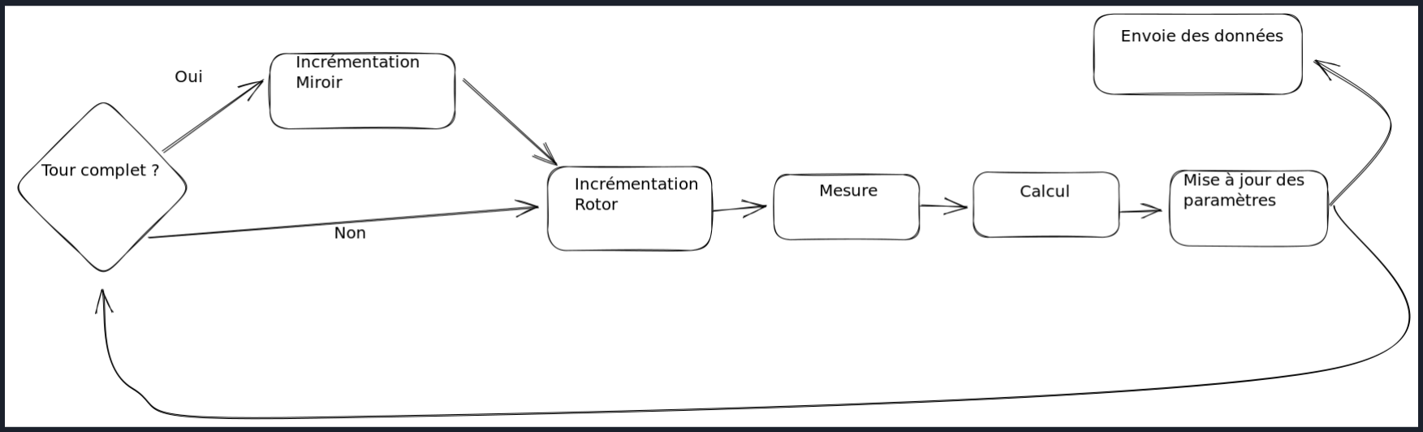
[picture p127: figure]

Conclusion et perspectives d’améliorations

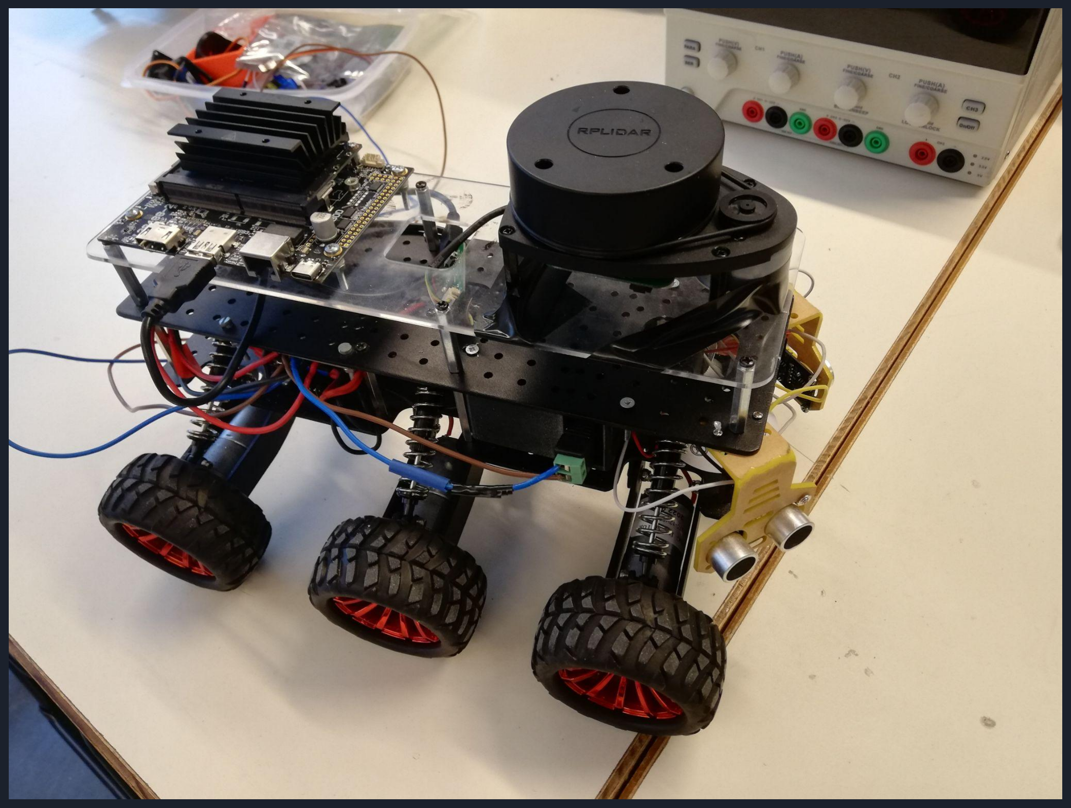
[picture p128: figure]

-navigation avec ROS

-intégration du Lidar sur le châssis

- finir notre propre châssis
- finir notre propre Lidar

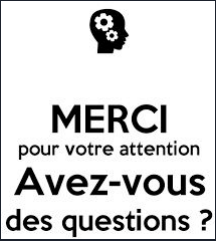
[picture p129: figure]
