MatthiasVermot-Desroches/Projet-ROB3/Rapport et article finaux/readme.md

Répertoire contenant le rapport de projet et la dernière version l'article en anglais
