MatthiasVermot-Desroches/Projet-ROB3/Rapports seances/readme.md

Ce répertoire contient les rapports de séances du projet de ROBO3.
