MatthiasVermot-Desroches/Projet-ROB3/Vermot-Desroches Matthias/NVIDIA/Readme.md

Répertoire contenant les fichiers du TD SQL sur VM
