MatthiasVermot-Desroches/Projet-ROB3/Vermot-Desroches Matthias/C++/TD Morse/Readme.md

Répertoire contenant les fichiers du TD de C++ sur le code Morse.
