MatthiasVermot-Desroches/Projet-ROB3/Rapports seances/seance19.pdf

04/04

J’ai décidé d’abandonner le rplidar car il n’apporte rien de plus que l’ancien si ce n’est d’autres problèmes (vitesse de rotation et angle non contrôlable).

Légère modification de l’algortihme qui modifie la vitesse de rotation en fonction de la résolution souhaité. Malheureusement il est difficile de tester correctement à cause de la liaison série de l’ordinateur qui perturbe la vitesse d’éxecution du programme.
