MatthiasVermot-Desroches/Projet-ROB3/Rapports seances/seance15.pdf

07/03

Apprentisage de FreeCAD :
https://www.youtube.com/watch?v=Odr5viqPwkchttps://www.youtube.com/watch?v=yS2o-uEmnxg

FreeCAD est un logiciel de modélisation paramétrique à l’instar de Fusion 360 (payant) mais qui est gratuit et open source. Il permet également de faire de la simulation ce qui permettera de refaire un chasis et de tester la solidité de celui-ci.
