MatthiasVermot-Desroches/Projet-ROB3/Rapports seances/seance8.pdf

14/12

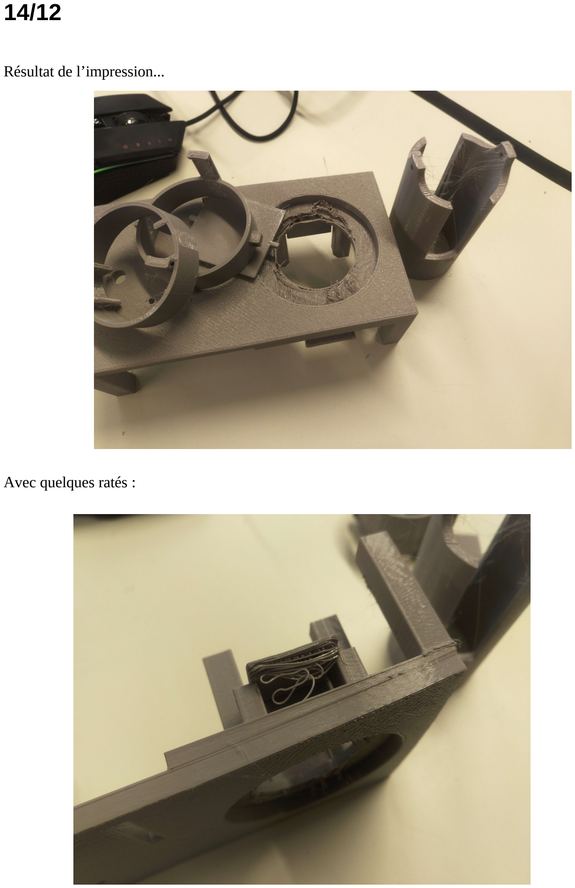
[picture p130: page 1]

Résultat de l’impression...

Avec quelques ratés :

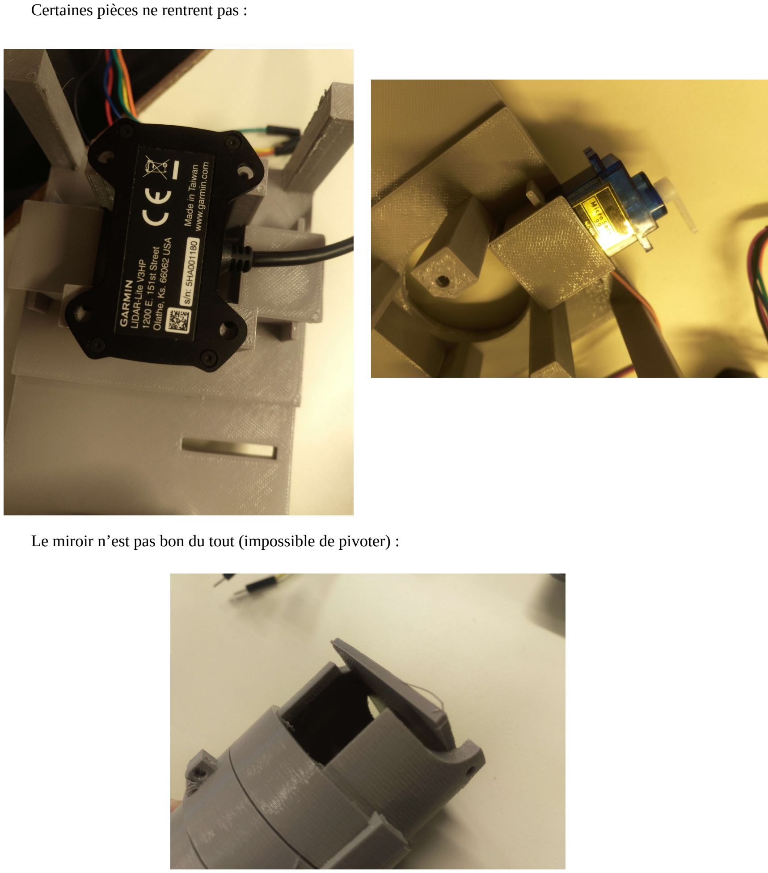
[picture p131: page 2]

Certaines pièces ne rentrent pas :

Le miroir n’est pas bon du tout (impossible de pivoter) :

Toutefois, avec un peu de bricolage, la majorité du système fonctionne :

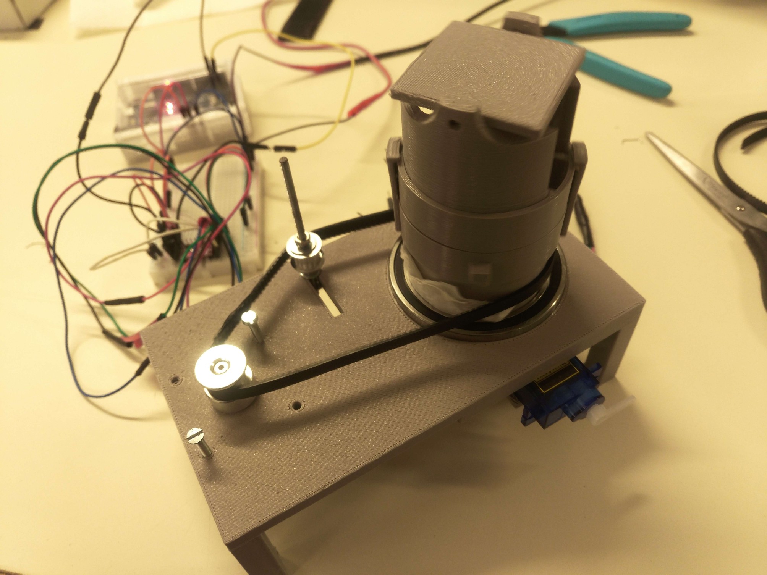
[picture p132: figure]
