MatthiasVermot-Desroches/Projet-ROB3/EG/CAO/arduino v5.3mf

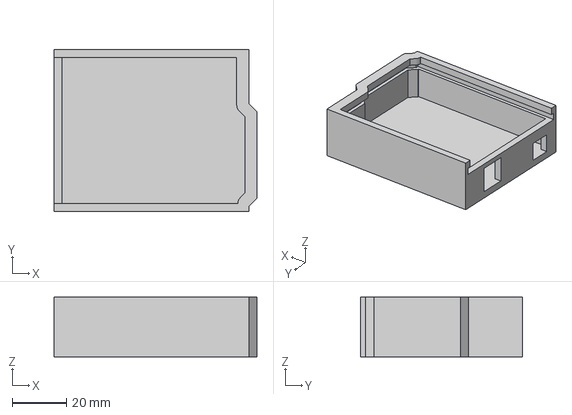
[picture p133: CAD file, 2022-10-19]
EG/CAO/arduino v5.3mf
75.0 x 60.0 x 22.0 mm
