MatthiasVermot-Desroches/Projet-ROB3/(list of files, cad)

Other CAD files:
EG/CAO/arduino v5.f3d
Vermot-Desroches Matthias/Boitier arduino/boitier Vermot-Desroches Matthias.f3d
