MatthiasVermot-Desroches/Projet-ROB3/EG/NVIDIA/TD-9-11-22/setup-dump-database-service.txt

-Mettre le chemin du script après ExecStart=
-Ajouter le timer : sudo systemctl enable --now dump-database.timer
